AeroX2/brother-cart-emulator/(list of files, drawings)

Other design files:
pcb-esp32/brother-esp32/brother-esp32.dsn
