AeroX2/brother-cart-emulator/pcb-esp32/brother-esp32/brother-esp32.kicad_pcb

## KiCad design pcb-esp32/brother-esp32/brother-esp32.kicad_pcb (2022-09-04)

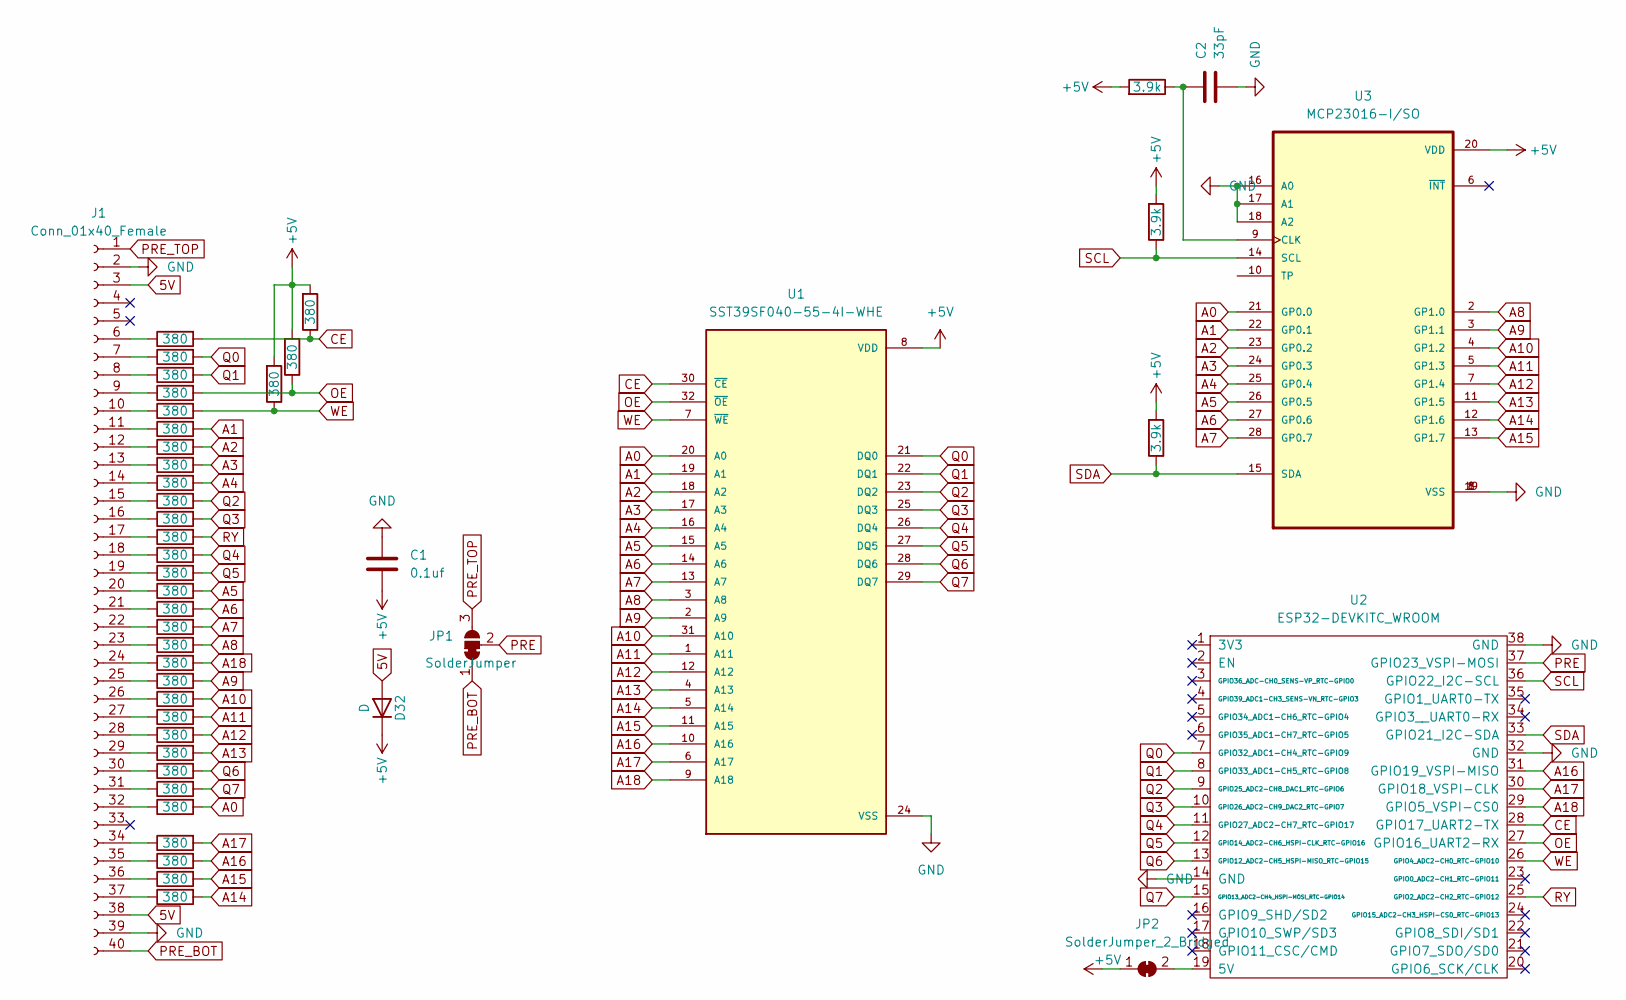
[picture p1: schematic brother-esp32.kicad_sch]

Parts:
C1: 0.1uf; C_0603_1608Metric_Pad1.08x0.95mm_HandSolder
C2: 33pF; C_0603_1608Metric_Pad1.08x0.95mm_HandSolder
D32: D; D_SOD-323_HandSoldering
J1: Conn_01x40_Female; PinHeader_1x40_SMD
JP1: SolderJumper; SolderJumper-3_P1.3mm_Bridged12_Pad1.0x1.5mm
JP2: SolderJumper_2_Bridged; SolderJumper-2_P1.3mm_Bridged_RoundedPad1.0x1.5mm
R1, R2, R3, R4, R5, R6, R7, R8, R9, R10, R11, R12, R13, R14, R15, R16, R17, R18, R19, R20, R21, R22, R23, R24, R25, R26, R27, R28, R29, R30, R31, R32, R33, R34: 380; R_0603_1608Metric_Pad0.98x0.95mm_HandSolder
R35, R36, R37: 3.9k; R_0603_1608Metric_Pad0.98x0.95mm_HandSolder
U1: SST39SF040-55-4I-WHE; SOP50P1400X120-32N; PARTREV C
U2: ESP32-DEVKITC_WROOM; ESP32-DOIT-DEVKIT
U3: MCP23016-I/SO; SOIC127P1030X265-28N

Connections:
5V: D32.2 (A), J1.3, J1.38
+5V: C1.2, D32.1 (K), JP2.1 (A), R32.2, R33.2, R34.2, R35.2, R36.2, R37.2, U1.8 (VDD), U3.20 (VDD)
A0: R27.2, U1.20 (A0), U3.21 (GP0.0)
A1: R6.2, U1.19 (A1), U3.22 (GP0.1)
A2: R7.2, U1.18 (A2), U3.23 (GP0.2)
A3: R8.2, U1.17 (A3), U3.24 (GP0.3)
A4: R9.2, U1.16 (A4), U3.25 (GP0.4)
A5: R15.2, U1.15 (A5), U3.26 (GP0.5)
A6: R16.2, U1.14 (A6), U3.27 (GP0.6)
A7: R17.2, U1.13 (A7), U3.28 (GP0.7)
A8: R18.2, U1.3 (A8), U3.2 (GP1.0)
A9: R20.2, U1.2 (A9), U3.3 (GP1.1)
A10: R21.2, U1.31 (A10), U3.4 (GP1.2)
A11: R22.2, U1.1 (A11), U3.5 (GP1.3)
A12: R23.2, U1.12 (A12), U3.7 (GP1.4)
A13: R24.2, U1.4 (A13), U3.11 (GP1.5)
A14: R31.2, U1.5 (A14), U3.12 (GP1.6)
A15: R30.2, U1.11 (A15), U3.13 (GP1.7)
A16: R29.2, U1.10 (A16), U2.31 (GPIO19_VSPI-MISO)
A17: R28.2, U1.6 (A17), U2.30 (GPIO18_VSPI-CLK)
A18: R19.2, U1.9 (A18), U2.29 (GPIO5_VSPI-CS0)
CE: R1.2, R34.1, U1.30 (~CE), U2.28 (GPIO17_UART2-TX)
GND: C1.1, C2.2, J1.2, J1.39, U1.24 (VSS), U2.14 (GND), U2.32 (GND), U2.38 (GND), U3.1 (VSS), U3.8 (VSS), U3.16 (A0), U3.17 (A1), U3.18 (A2), U3.19 (VSS)
unnamed: C2.1, R35.1, U3.9 (CLK)
unnamed: J1.6, R1.1
unnamed: J1.7, R2.1
unnamed: J1.8, R3.1
unnamed: J1.9, R4.1
unnamed: J1.10, R5.1
unnamed: J1.11, R6.1
unnamed: J1.12, R7.1
unnamed: J1.13, R8.1
unnamed: J1.14, R9.1
unnamed: J1.15, R10.1
unnamed: J1.16, R11.1
unnamed: J1.17, R12.1
unnamed: J1.18, R13.1
unnamed: J1.19, R14.1
unnamed: J1.20, R15.1
unnamed: J1.21, R16.1
unnamed: J1.22, R17.1
unnamed: J1.23, R18.1
unnamed: J1.24, R19.1
unnamed: J1.25, R20.1
unnamed: J1.26, R21.1
unnamed: J1.27, R22.1
unnamed: J1.28, R23.1
unnamed: J1.29, R24.1
unnamed: J1.30, R25.1
unnamed: J1.31, R26.1
unnamed: J1.32, R27.1
unnamed: J1.34, R28.1
unnamed: J1.35, R29.1
unnamed: J1.36, R30.1
unnamed: J1.37, R31.1
unnamed: JP2.2 (B), U2.19 (5V)
OE: R4.2, R33.1, U1.32 (~OE), U2.27 (GPIO16_UART2-RX)
PRE: JP1.2 (C), U2.37 (GPIO23_VSPI-MOSI)
PRE_BOT: J1.40, JP1.1 (A)
PRE_TOP: J1.1, JP1.3 (B)
Q0: R2.2, U1.21 (DQ0), U2.7 (GPIO32_ADC1-CH4_RTC-GPIO9)
Q1: R3.2, U1.22 (DQ1), U2.8 (GPIO33_ADC1-CH5_RTC-GPIO8)
Q2: R10.2, U1.23 (DQ2), U2.9 (GPIO25_ADC2-CH8_DAC1_RTC-GPIO6)
Q3: R11.2, U1.25 (DQ3), U2.10 (GPIO26_ADC2-CH9_DAC2_RTC-GPIO7)
Q4: R13.2, U1.26 (DQ4), U2.11 (GPIO27_ADC2-CH7_RTC-GPIO17)
Q5: R14.2, U1.27 (DQ5), U2.12 (GPIO14_ADC2-CH6_HSPI-CLK_RTC-GPIO16)
Q6: R25.2, U1.28 (DQ6), U2.13 (GPIO12_ADC2-CH5_HSPI-MISO_RTC-GPIO15)
Q7: R26.2, U1.29 (DQ7), U2.15 (GPIO13_ADC2-CH4_HSPI-MOSI_RTC-GPIO14)
RY: R12.2, U2.25 (GPIO2_ADC2-CH2_RTC-GPIO12)
SCL: R36.1, U2.36 (GPIO22_I2C-SCL), U3.14 (SCL)
SDA: R37.1, U2.33 (GPIO21_I2C-SDA), U3.15 (SDA)
WE: R5.2, R32.1, U1.7 (~WE), U2.26 (GPIO4_ADC2-CH0_RTC-GPIO10)

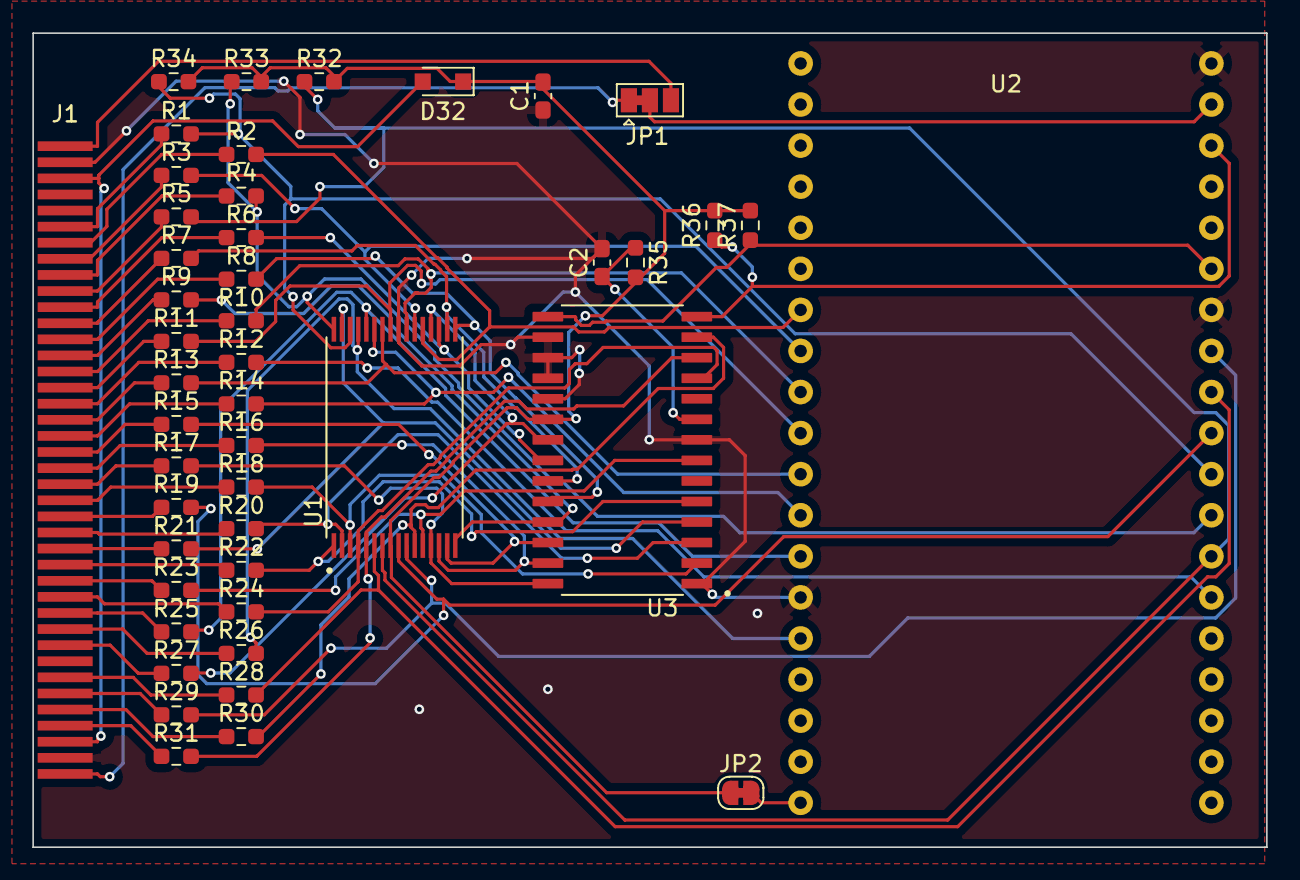
[picture p2: board brother-esp32.kicad_pcb from above]

Board: 2 copper layers, 76.3 x 50.3 mm, 46 parts (0 on the bottom side), 72 nets.
