AeroX2/brother-cart-emulator/(threads)

Thread 1 (2023-02-17):

trying to make this work with innovis 500d

bezmi, 2023-02-17:
I have inherited an old innovis 500d and I'm trying to get my version of this PCB (created to use whatever microcontrollers I had lying around) working with the machine. My PCB uses a teensy 3.5 to program the same sst39 flash chip.

After flashing `image.bin` from this repository onto the flash chip and plugging into the card slot, nothing happens. I noticed that on my machine's card reader PCB, the PRE_TOP pin is connected to GND. Booting up with JP1 bridged, I get *"This embroidery card cannot be used in this machine"* when trying to access the menu. I have also tried generating my own `image.bin` via PED-basic and your `cracker.py` script which outputs a ~64KB `image.bin`. I get the same error when trying to use this file. I have also tried the teddy bear `putty.txt` which you posted on the EEVBlog forum, same message.

I am fairly certain that this machine should be working with the 100x100mm hoop size in PED-basic with a 4M card, so kind of lost with what to try next. Thought I'd raise an issue here before going through the wait for a 2nd hand card to arrive via ebay for reverse engineering purposes. Any ideas?

bezmi, 2023-02-17:
Thought I'd update with a clarification of the behaviour I'm seeing with `cracker.py`. It always seems to generate a 64KB `image.bin`, no matter how many designs are selected. After the *"please wait a while..."* progress bar when clicking the `write to card` button. PED-Basic closes. I have attached the output from `cracker.py` which is printed in the terminal. I have also attached the `image.bin` that is generated for the *"assortment.pes"* built-in pattern. If you could test this on your machine to confirm whether it is detected correctly, that would be a great help in ruling out the software side of things for me.
[image_bin.txt](https://github.com/AeroX2/brother-cart-emulator/files/10767400/image_bin.txt)
[cracker_output.txt](https://github.com/AeroX2/brother-cart-emulator/files/10767367/cracker_output.txt)

bezmi, 2023-02-18:
Just an update. I was able to get the kirby `image.bin` uploaded and recognised, however, the images using `cracker.py` were still not working. I changed the value on [line 70](https://github.com/AeroX2/brother-cart-emulator/blob/4cbaff421ebe7be2ceeb72bb8b466a4975f6d403/image-dumper/cracker.py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) to 0x80000 to get a 512KB file. I then overwrote the header (offsets 0x000 to 0x180) with the one from the kirby file and the files show up.

I noticed that the 'b' in the 'brother_sewing' (offset 0x100) part of the header was 0xFF instead of 0x62 for 'b', so I made that change and the files show up.

jridey, 2023-02-18:
>I noticed that the 'b' in the 'brother_sewing' (offset 0x100) part of the header was 0xFF instead of 0x62 for 'b', so I made that change and the files show

Glad to hear that you got it working!

>0x80000 to get a 512KB file. I then overwrote the header (offsets 0x000 to 0x180) with the one from the kirby file and the files show up.

I'm surprised that this works, the current patcher assumes that the card is the smallest size and so is patched to take that code execution path.
When I get some time, I'll see if I can harden the cracker.py file up a little and maybe add options for card size and loop size.

bezmi, 2023-02-18:
> I'm surprised that this works
Yeah that makes two of us. The image I made with two of the default patterns contains data out to `1B5E0` and then FF for the remainder.

Any idea why the header would be mangled in the first place? I tried to get into the guts of the dll but didn't get too far.

I would like to take a crack at writing a script to generate the image from a PES file without the dll. You mentioned on the eevblog thread that you were able to read out stitch data after adding an offset, so that part shouldn't be too difficult, do you know whether there is metadata about the files stored in the flash - such as size, number of files, etc? Is it just reading the whole thing at boot and calculating it that way? The short header at the start also seems to have some data in it.

AeroX2, 2023-03-07:
>I would like to take a crack at writing a script to generate the image from a PES file without the dll.

Yeah I would love for this to happen as well, just when I was browsing around the decompiled code it seemed quite complicated with a lot of moving parts (plus I'm quite a novice when it comes to reverse engineering), so I eventually took the route of just hooking into the DLL.

>do you know whether there is metadata about the files stored in the flash - such as size, number of files, etc?

There were some references to size and number of files but I couldn't really follow the logic on where it places it and how, probably just needs more eyes to look at it.

bezmi, 2023-03-09:
I have been taking a look at the generated files themselves. Take a look at [my repo](https://github.com/bezmi/brother_embroidery_card_experiments). The `experiments.ipynb` notebook contains some code to go through the files and plot the data as a bitmap. You can see that there are a lot of UI elements stored on the card along with the thumbnails from the PEC file before the stitch data.

bezmi, 2023-03-10:
Hey mate, I have taken a bit of time to trawl through and understand the structure of the binaries. [See my notes here](https://github.com/bezmi/brother_embroidery_card_experiments/blob/main/notes.org). I think this should (probably) be enough to get started on testing with an image writer program. I'm waiting on a replacement FFC cable after I broke the last one by taking the machine apart too many times - once that's done I'll make a start on the software.

Thread 2 (2023-12-10):

Need a hand with the jumpers

MattBoog, 2023-12-10:
Hey there,
Looking into this project and working on getting the bom, gerber and position files for jlc, but I noticed 2 places with jumpers. Do you have some kind of guide or whatever to know what I should and shouldn't bridge?

MattBoog, 2023-12-10:
Adding to that, do I need a special kind of diode for D32?

AeroX2, 2023-12-10:
>Looking into this project and working on getting the bom, gerber and position files for jlc, but I noticed 2 places with jumpers. Do you have some kind of guide or whatever to know what I should and shouldn't bridge?

Been a while since I had a look at this but from what I remember,
JP1 you should be able to bridge both together, it is used for card presence detection and I was going to use it for disconnecting the card, writing to the flash and reconnecting the card, although don't think I got it quite working, might potentially need a transistor instead.

JP2 you should be able to leave alone, it was mostly to disconnect the ESP32, I was concerned that the ESP32 might draw to much power from the card slot and cause issues with the machine but from my testing I'm pretty sure the 5V stayed pretty stable but YMMV

>Adding to that, do I need a special kind of diode for D32?

Nah just another small piece of protection, helped quite a bit in the end since it was very easy to misalign the pins and accidently stick GND to 5V and 5V to GND

This was also was my first PCB so the routing isn't the prettiest and might have signal integrity issues, if you don't really need the ESP32 have a look at https://github.com/bezmi/brother_embroidery_card_experiments for a PCB that uses a Teensy instead and the routing it done much better :)

MattBoog, 2023-12-10:
That other design uses a teensy3.5 which is discontinued. It's replacement is the 4.1, which isn't 5v tolerant. So it'll have to be the esp32 variant.
For the diode, since it's nothing specific, a 1N4148WS should be fine right?

Thread 3 (2024-08-20):

Write of image binary file using PED Basic and cracker.py with radare2 fails

maehw, 2024-08-20:
Hi @AeroX2 !

Thanks for your efforst in making writing the embroidery card binary images writeable to files!

I'ved tried to get the toolchain running on my machine but have failed so far. Maybe you could give me some guidance here?

Versions:

- PED-Basic v1.07 (the about dialog outputs a copyright message "2002 - 2005")
- CardIO.dll seems to be version 3.2.1.1 from 22.09.2005
- Python 3.12.5
- radare2-5.9.4-w64
- Windows 10

I don't really think that you had a different version of PED-Basic or the CardIO.dll as both seem pretty old - but you never know.

I somehow guess that I am running into Windows user rights issues. I had installed PED-Basic as the local admin and tried to execute `pelite.exe` via `python cracker.py` as normal user. Next, I tried to modify all access rights to all files in a way that a normal user should have full access. I then even copied everything into C:\Users\User\Documents\PED-Basic and it still does not work.

I'll share snippets from the log of `python cracker.py`, especially those that indicate warnings or errors:

```
WARN: Relocs has not been applied. Please use `-e bin.relocs.apply=true` or `-e bin.cache=true` next time
ERROR: Cannot debug file (pelite.exe) with permissions set to 0x7Reopening the original file in read-only mode.

INFO: Spawned new process with pid 13068, tid = 3036
INFO: File dbg://C:\\Users\\User\\Documents\\PED-Basic\\pelite.exe reopened in read-write mode
WARN: Relocs has not been applied. Please use `-e bin.relocs.apply=true` or `-e bin.cache=true` next time
13068
(13068) loading library at 0x00007FFFD20B0000 (C:\Windows\System32\ntdll.dll) ntdll.dll
...

WARN: Relocs has not been applied. Please use `-e bin.relocs.apply=true` or `-e bin.cache=true` next time
[Relocations]

vaddr      paddr      type   ntype name
---------------------------------------
0x0003bda4 0x00036048 SET_32 3     CardIO.dll_public: void __thiscall CCardIO::constructor(int)
...

596 relocations

w \x90 @ 4273898
w \x90 @ 4273899
w \x90 @ 4273900
w \x90 @ 4273901
w \x90 @ 4273902
w \x90 @ 4273903
w \x90 @ 4310977
w \x90 @ 4310978
w \xeb @ 4275697
w \xeb @ 24027
ERROR: Cannot write. Use `omf`, `io.cache` or reopen the file in rw with `oo+`
w \xeb @ 24099
ERROR: Cannot write. Use `omf`, `io.cache` or reopen the file in rw with `oo+`
w \xeb @ 24174
ERROR: Cannot write. Use `omf`, `io.cache` or reopen the file in rw with `oo+`
WARN: base addr should not be larger than the breakpoint address
WARN: Cannot set breakpoint outside maps. Use dbg.bpinmaps to false
INFO: Continue until 0x00006ad5 using 1 bpsize
```

I guess that the `ERROR: Cannot write.` messages are what really makes me trouble. The file `image.bin` however is created with 64 kBytes but only contains `0xFF` (what would be an empty flash EEPROM/memory). Is there anything I should inspect?

Any hints are very appreciated!

M.

PS: I've also tried to share my findings in the EEVblog forum thread https://www.eevblog.com/forum/reviews/brother-(possibly-also-bernina)-embroidery-machine-memory-cards/?all

AeroX2, 2024-08-21:
Yeah you are right on with radare2, this script is quite old at this point and so hasn't really kept up to date with radare2 hence the issues.

The read write issue is actually because it is trying to write into the wrong addresses since it was unable to find the correct memory address for `CardIO.dll`.
I've just updated the script and tested it and it seems to work, though I'm testing within a virtual machine with ASLR turned off so your milage may vary.

The other issue I see you might be running into is if the program is still open in the background you also can't write into it, you need to close all instances of `cracker.py` and the program and then run it and it should hopefully work 🤞

AeroX2, 2024-08-21:
Just tested on a non-VM machine and everything seemed to worked with the updated script

Windows 11
Python - 3.12.0
r2pipe - 1.9.4
PELite 1.07

AeroX2, 2024-08-26:
>I forked your repository and suggest a few minor changes, see https://github.com/AeroX2/brother-cart-emulator/pull/4 . I've done this primarily to help other users understand your code without doing their own research/debugging. Feel free to discard them. 😉

Thanks for the PR, definitely will make it easier for future users

>The card memory usage indicator doesn't work with the patches. Do you know why? Do you think there is an easy fix? Would be nice to have direct feedback instead of the "0%" bar.

Unlikely to be an easy fix, I suspect the reason for the 0% is because I'm not actually writing to a card, only looking at the memory and taking the data that would be written to the card, the progress bar is likely tied to the actual card writing.

>Why is the output binary file 64 kiBytes (65'536 bytes)? If I get it right the upper technial limit is 512 kiBytes? Do you think this is fix-able as well?

Two things, one is I pick the smallest card size of 64kb, you can see in the README.md I pick the address 0x10005E6B, to override and this corresponds with 64kb, for 512kb, you'll need address 0x10005E7D (probably).
Second is that `pxj 0x10000` in `cracker.py` is dumping out only 64kb worth of data, so changing those will allow you to dump more.

>What license is your repo (and my contributions)? I think you haven't added a LICENSE file yet. I'd be happy if this was open source (and maybe it kind of already is... never had repos without an explicit license).

I'll add a MIT license, that way people are free to use it the way they want

maehw, 2024-08-26:
Hi James,

thanks for everything:

- Accepting my PR
- Keeping the "tested configurations" sections in README and clarifying your setup
- Adding the LICENSE file
- Being patient, nice and responsive to my requests!

I just got a brother PED-Basic in the mail. I had not planned to buy one, but that one was even kind of affordable. This should make some research easier in case I keep being motivated.

It really seems that every time the usage bar is updated, the PED card reader is accessed (red busy LED turns off for a short moment). The blue color part is the amount of memory already reserved by the PES files "copied to the right side". The cyan color part is the extra amount of memory "copying" the selected PES file on the left would add on top:

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

Interestingly, the GUI seams to offer write-only access to the card. I have no clue if my card had been written before or erased in a way. But even after writing some of the samples and re-plugging the card... nothing on the right appears without copying PES files from left to right. So, I guess that the card is just completely whiped and the generated binary is written... w/o data being read. I guess that at least some manufacturer/model data from the EEPROM/flash memory should be read to determine the card size - but that's a wild guess.

Summing up: thanks for your help! Rowing this boat together definitely makes it more fun!

maehw, 2024-08-27:
Hi again,

I am trying to print the disassembly of functions in `pelite.exe` and `CardIO.dll` to better understand the context of the patches/ your screenshots so that I can extend `cracker.py`. So I am asking you to shed some light into the darker spots I do not fully understand yet.

I've pushed a commit on the fork of your repo:
https://github.com/maehw/brother-cart-emulator/commit/cf5b36798d20327e7ab338c64bfde90991501025

When being exeucted, I get the following output:

```
Printing imported CardIO functions...
signature: void__thiscallCCardIO::constructor(int), address: 0x00436048
32 bit word: 0x10001980
signature: enumCIOError__thiscallCCardIO::ChkCardWriterConnected(int,unsignedchar*,int*), address: 0x0043604c
32 bit word: 0x10001df1
signature: enumCIOError__thiscallCCardIO::Receive(classCObArray*,int,voidconst*,voidconst*), address: 0x00436050
32 bit word: 0x10001ca1
signature: void__thiscallCCardIO::ResetCardID(void), address: 0x00436054
32 bit word: 0x10001940
signature: enumCIOError__thiscallCCardIO::Send(classCObArray&,voidconst*,voidconst*,enumCCardAtrbType*), address: 0x00436058
32 bit word: 0x10001d0f
signature: enumCIOError__thiscallCCardIO::ChkCardVolume(classCObArray&,int&,int&,enumCCardAtrbType*), address: 0x0043605c
32 bit word: 0x10001d80
```

So it seems that the exported functions are known to r2 here. I used r2 command `ii`.
As the `address` values are `+4` byte each - I guess this is rather a function pointer table (32 bit addresses from good' ol' 32 bit world?) somewhere in memory where the lib is loaded during runtime.

When having a look at the values at those addresses `pxw 4 @ ...`, I get those `0x1000____` addresses. Where does this offset come from? I'v also spotted it in your code `0x10000000`. Unfortunately, I wasn't able to get a dump of the functions there (command `pdf @ ...`).

What am I missing here?

I'd also like to understand why you chose `cracker.py` to run until addresse `0x6ad2`/`0x6b0e`. Without the disassembly I am lacking context here.

Also, I'd like to explore the code area more where the different flash sizes are used.

How did you get the GUI view? Is it another RE tool? Prefereably, I'd like to get the disassemblies in the context of running `cracker.py`.

Your help is very much appreciated!

Cheers

AeroX2, 2024-08-28:
> When having a look at the values at those addresses pxw 4 @ ..., I get those 0x1000____ addresses. Where does this offset come from? I'v also spotted it in your code 0x10000000. Unfortunately, I wasn't able to get a dump of the functions there (command pdf @ ...).

Hmm not sure why `pdf` might not be working but I'd probably recommend doing it in Ghidra since that tool is much more friendly, I only used r2pipe because it was the only scriptable debugger that I knew of and too be honest was a bit of a pain to work with.
As for the 0x10000000, that address is the default address Windows uses for any DLL's that are loaded by a program that aren't rebased a different address so in this case the CardIO.dll
https://devblogs.microsoft.com/oldnewthing/20141003-00/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,you%20start%20colliding%20with%20DLLs.
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

>I'd also like to understand why you chose cracker.py to run until addresse 0x6ad2/0x6b0e. Without the disassembly I am lacking context here.

Yeah all good, reverse engineering is quite difficult and you have to do a bit of guess work, so if you look at offset `0x6b11`, there is a function which is setting up the Brother copyright header, this isn't writing the embroidery data that comes later
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
But I know that this is the function that write into the card data memory location so I can break at this point and extract it with `p8j 4 @ rcx`, (technically I could have also done this at `0x6b0e` but I felt it was just easier to do at this location because I knew the address was in register rcx)

The `0x6b11` function is only called by one other function (offset `0x6ac8`), and there are three other functions called here which write the embroidery data so offset `0x6b0e` is the `ret` instruction and is the first instruction where I know that the embroidery data is all written to memory and I can safely extract it.

https://github.com/user-attachments/assets/c987ba6e-fbaa-4aeb-a996-2f01ca683887

>How did you get the GUI view? Is it another RE tool? Prefereably, I'd like to get the disassemblies in the context of running cracker.py

I use a tool called Ghidra (https://ghidra-sre.org/), x64dbg (https://x64dbg.com/), along with retsync (https://github.com/bootleg/ret-sync).
You probably just need Ghidra, which can decompile the program into a C-ish program state but if you want to see what exactly is happening at each state you need to step through it with a debugger (x64dbg) and being able to look back and forth at what is happening with the debugger and Ghidra is where ret-sync comes in.

maehw, 2024-09-01:
Hi James / @AeroX2 ,

thanks for your detailed explanations.

This gave me new insights as I am an embedded software developer and not very experienced with application development - at least not on the reverse engineering side of things.

Using Ghidra alone for analysis of the DLL's disassembly did the trick. If I find time and need for setting up the other tools, I might write you again.

In the meantime, I've added support for multiple card sizes - see pull request #5 .

Would be great to get the "progress bar" (memory card usage indicator) feature working as I've seen single PES design pattern files overrunning the default 64 kiBytes (see explanation in my pull request).

HTH / Cheers

maehw, 2024-09-06:
Hello again,

I've dived deeper into the disassembled code of both pelite.exe and CardIO.dll.

Unfortunatel, I haven't been able to locate the code which calculates/draws the memory card usage indicator. Could you maybe give me some more guidance here to make this happen?

So far, I've "only" used Ghidra for static analysis.

I've mainly used your patches to get some context and the strings I found (many printf format specifiers). I've also seen some calculations which I thought were suspicious - without any luck.

The function at 0x00416361 seems to format the relative and absolute sizes (`%3d%%` resp. `%5s%s X %5s%s`) of the selected pattern which are displayed in the lower left corner of the PED-Basic window. I've verified this by replacing single characters in those format specifiers.

I've also found another percentage value being formatted in the function at 0x0041c67b -- it is the relative pattern size displayed on the right window side after copying it to the card (format specifier `%d%%`).

This was interesting, but it did not lead me in the right direction.. because the `100%` value is never re-labeled. Only the blue/cyan rects are displayed. This should also happen when a pattern is selected on the left hand side.. but I did not find an entry function (on-item-selection-callback?!) where this is hooked.

In addition, I've also read @bezmi's comment https://github.com/AeroX2/brother-cart-emulator/issues/1#issuecomment-1435530216 -- I also see a corrupted string in the output binary file (`ÿrother_sewing`) - do you have an idea what could cause this issue? Did the corrupt images work with your machine?

Another hint: in the patch descriptions of `image-dumper/README.md`, you call it "Bypass ChkCardVolume". Strictly speaking the method seems to be called but the result value is ignored and your patches modify the code to make it look like everything turns out as expected. I found this pretty misleading.

This is fun.. and tedious at the same time.

maehw, 2024-09-15:
Hi James,

> You probably just need Ghidra, which can decompile the program into a C-ish program state but if you want to see what exactly is happening at each state you need to step through it with a debugger (x64dbg) and being able to look back and forth at what is happening with the debugger and Ghidra is where ret-sync comes in.

I'd be interested in a brief description how to set the three tools up in the sync'ed mode you described. Can you also see the decompiled C code? I can run `pelite.exe` from x64dbg but I have no clue how to start a Ghidra session for the dynamic analysis and also no idea what to do with the ret-sync release file (which seems to be a single `*.dp64` resp. `*.dp32` file).

Have a nice sunday!

AeroX2, 2024-09-16:
>This was interesting, but it did not lead me in the right direction.. because the 100% value is never re-labeled. Only the blue/cyan rects are displayed. This should also happen when a pattern is selected on the left hand side.. but I did not find an entry function (on-item-selection-callback?!) where this is hooked.

I suspect this is because it is using the Windows API for progress bars and so there isn't a "100%" label in the program just a function that is advancing the ticks for the progress bar but I haven't dived into this myself.

>In addition, I've also read @bezmi's comment https://github.com/AeroX2/brother-cart-emulator/issues/1#issuecomment-1435530216 -- I also see a corrupted string in the output binary file (ÿrother_sewing) - do you have an idea what could cause this issue? Did the corrupt images work with your machine?

I don't think I've seen a `ÿrother_sewing` just `ÿbrother_sewing` but I suspect it would still work since I don't think the headers are really read by the machine just the offsets

>I'd be interested in a brief description how to set the three tools up in the sync'ed mode you described.

ret-sync just makes the debugger and Ghidra talk to each other so that the line that you are currently breakpointing on is the same line that is highlighted in Ghidra. This setup makes it a touch easier to reverse engineer but you can still look at the line numbers manually and just match them up.

>Can you also see the decompiled C code?

Ghidra shows decompiled C code but it is still heavily obfuscated and not easy to navigate.

>I can run pelite.exe from x64dbg but I have no clue how to start a Ghidra session for the dynamic analysis and also no idea what to do with the ret-sync release file (which seems to be a single *.dp64 resp. *.dp32 file).

You can have a look at the `ret-sync` page for their Ghidra (https://github.com/bootleg/ret-sync?tab=readme-ov-file#ghidra-usage) instructions

>(which seems to be a single *.dp64 resp. *.dp32 file).

These are the plugin files that x64dbg uses, you need to drag and drop them in x64dbg plugin folder

bezmi, 2024-09-16:
Hey @maehw, have you tried with the vikant writer workflow from my repo? There is an ipython notebook that shows how to locate the thumbnail data and the python script emulates a vikant writer so that you can create flash images from custom stitch data (you don't need any hardware to do it). I also have notes which I think are detailed enough to be able to replace thumbnails and stitch data in a given vikant/PED file with our own stuff using python directly. Let me know if you want to look at any of those binary files with custom stitch data.

I started with reverse engineering the binaries, but it gets complicated really fast and it was actually more instructive to jump around the card data in python.

maehw, 2024-09-27:
Hi @AeroX2 and @bezmi ,

thank you for your replies.

I've dived deeper into CardIO.dll and also USB communication with the brother's card reader/writer.

Actually, it's really the case that "`ÿbrother_sewing`" (where `ÿ` is `0xFF`) is written into the card's memory (at offset 0x170). The very last write operation (over)writes the single character '`b`' at 0x170 (not at 0x100 as mentioned by you, @bezmi , in the linked issue). So maybe the character is wrong in the binary output file as it comes out of `cracker.py`. This must be some special handling by either the DLL or the standalone application. It actually _may_ prevent the machine from reading the card. I also had seen several string comparisons in the code.

@AeroX2 : I haven't tried the x64dbg + Ghidra + ret-sync combination (yet). But thanks for the instructions!

@bezmi : I couldn't get the Vikant-based workflow running. That's what I wrote in the eevblog.com forum:

> Other things I could not get working: the Vikant card emulator (another Python script)... or rather I could not get it working with the "Ultimate Explorer for Brother" (Serial port version). Even though I created virtual COM ports with com0com, only the Python side connected... and Vikant's Ultimate Explorer didn't want to open or even find the COM port. So this approach currently won't work for me to write own card binaries from PES files.

So it seems that I already had issues with getting the virtual COM port working with the software (that was before I got myself a brother PED card reader/writer + re-writeable memory card which works well with brother's PED Basic software). Which version of the Vikant software have you been using? I'd like to have a working toolchain on Linux/MacOS even though the patched PED Basic approach (running under Windows) works - and it works nicely!

maehw, 2024-10-06:
Hi all.

New findings & fixes (#7):

- I think the card memory sizes have been wrong, see #6.
- Writing "ÿrother_sewing" instead of "brother_sewing" will let my machine (brother PE-150) ignore the memory card and even prevent any operation of the machine at all and keep beeping... - so I fixed it in `cracker.py` data postprocessing. The puzzle about different locations of the string is now also solved for me: it depends on the hoop size of the character is written at 0xC0, 0x100 or 0x170. According to the "code" 0x280 and 0x28E would also be valid locations - but I don't know under what circumstances - haven't seen them being used by PED Basic. The `b` is the final character which is written to EEPROM/flash - so the machine could also use it to check if the memory write operation had been completed successfully or if it would likely face a corrupt card image.

HTH

maehw, 2024-10-07:
Thanks for your help. I'd be okay if this issue was closed. I'd then open new issues for other, smaller subtopics - if you're okay with that.

bezmi, 2024-11-28:
@maehw I was just using the version from their website: https://vikant-emb.com/downloads I haven't checked to see if it still works though. I can't think of any issues I had other than having to run as administrator to access the com ports. Glad to know that PED Basic worked for you.
